samleoqh/ATmega-MCU/src/IO_WA/IO_WA/mylib/usart_library.h

/*
* usart_library.h
*
* Created: 16-10-2016 20:49:13
* Author: ravim & Brian
*/

// Some functions modified from part of Richard's code
// of USART and Timing diagnostic samples


#ifndef __USART_LIBRARY_H__
#define __USART_LIBRARY_H__

void USART_SETUP_9600_BAUD_ASSUME_1MHz_CLOCK();
void USART_TX_SingleByte (unsigned char cByte);
void Initialise_Usart(int32_t baudrate);

void USART0_TX_SingleByte(unsigned char cByte);	//	from Richard's code
void USART0_TX_String(char* sData); // from Richard's code
void USART0_DisplayBanner_Head();  // from Richard's code
void USART0_DisplayBanner_Tail();	// from Richard's code

#endif //__USART_LIBRARY_H__
