samleoqh/ATmega-MCU/(commit log)

2016-11-04 sample code
2016-11-09 prototype v1.0
2016-11-09 fix unstable adc
2016-11-20 add RAVIs PWM code
2016-11-20 bug fix for mode data
    [main.c]
